Lee-Stone/esp32s3-lvgl-terminal/SquareLine_Project/assets/aa.jpg

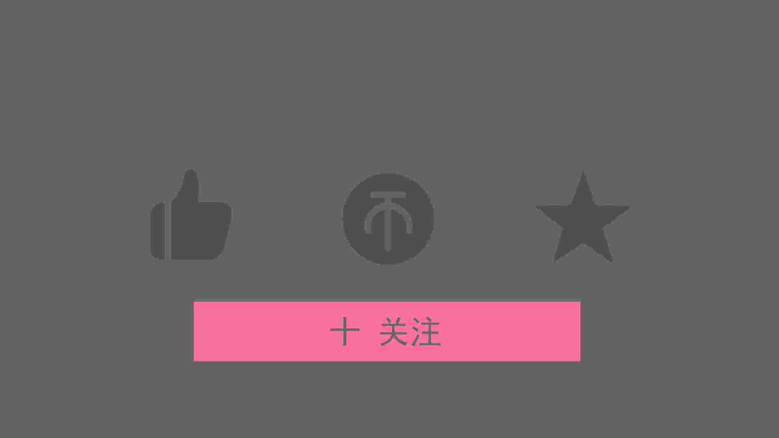
SquareLine_Project/assets/aa.jpg
