Lee-Stone/esp32s3-lvgl-terminal/SquareLine_Project/assets/ab.gif

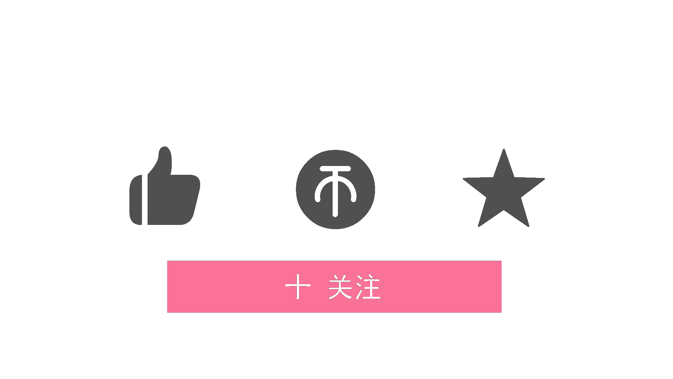
SquareLine_Project/assets/ab.gif
