Lee-Stone/esp32s3-lvgl-terminal/hardware/BOM_PCB_基于ESP32S3的智能终端V2.0.xlsx

No. | Quantity | Comment | Designator | Value
1 | 5 | Key_SMD_3x4x2 | BOOT,KEY1,KEY2,KEY3,RST
2 | 5 | 10uF | C1,C4,C5,C9,C11 | 10uF
3 | 10 | 100nF | C2,C3,C6,C7,C8,C10,C12,C13,C14,C17 | 100nF
4 | 1 | 100uF | C16 | 100uF
5 | 1 | 1uF | C18 | 1uF
6 | 1 | TF-02A | CARD1
7 | 1 | LED_0603-R | CHRG
8 | 1 | ZX-XH2.54-4PWT | CN1
9 | 1 | 1N5819WS | D1
10 | 2 | WAFER-PH2.0-2PWB | H1,H2
11 | 1 | MSM261D3526H1CPM | MIC
12 | 1 | LED_0603-B | PWR
13 | 1 | AO3401A | Q1
14 | 2 | AO3406 | Q2,Q3
15 | 1 | 0.4Ω | R1 | 0.4Ω
16 | 11 | 10K | R2,R3,R8,R9,R11,R13,R14,R15,R16,R17,R21 | 10K
17 | 1 | 1.5K | R4 | 1.5K
18 | 3 | 1K | R5,R6,R7 | 1K
19 | 6 | 5.1K | R10,R12,R18,R19,R20,R22 | 5.1K
20 | 1 | XL-3528RGBW-HM | RGB
21 | 1 | LED_0603-G | STDBY
22 | 1 | SS-1230W-G2 | SW1
23 | 1 | ESP32-S3-WROOM-1-N16R8 | U1
24 | 1 | TP4056X-42-ESOP8 | U2
25 | 1 | RT9013-33GB | U3
26 | 1 | 2.8寸电阻触摸屏 | U4
27 | 1 | XPT2046 | U5
28 | 1 | NS4168 | U6
29 | 1 | TYPE-C 16P QTGM027 | USB1
备注 | 2.8寸电阻触摸屏购买链接： 【淘宝】限时淘金币抵0.4元 https://e.tb.cn/h.RAMRivuBVRcLwcx?tk=EonXgpxdo21 CZ005 「2.4寸TFT显示屏电容触摸屏SPI串口屏4线焊接18pin驱动IC7789/9341」 点击链接直接打开 或者 淘宝搜索直接打开 其他元器件直接在淘宝上按照Comment名称搜索即可。
