Lee-Stone/esp32s3-lvgl-terminal/hardware/SCH_Schematic_基于ESP32S3的智能终端V2.0.pdf

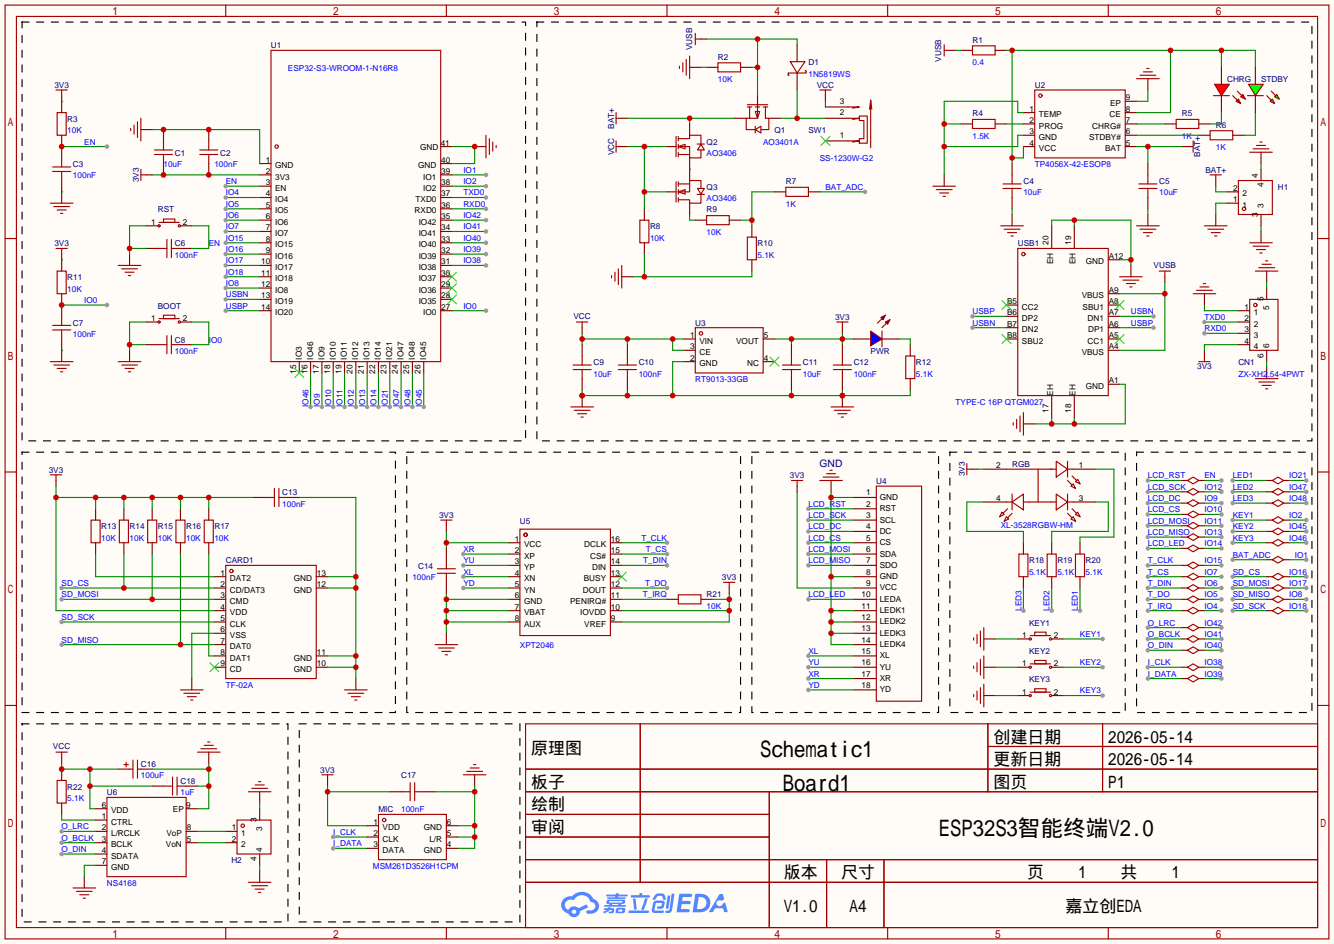
[picture p7: page 1]

IOVDD 10 PENIRQ# 11 DOUT 12 BUSY 13 DIN 14 CS# 15 DCLK 16

原理图 | Schematic1 | 创建日期 | 2026-05-14

更新日期 | 2026-05-14

板子 | Board1 | 图页 | P1
绘制 | | ESP32S3智能终端V2.0
审阅

V1.0 | A4 | 嘉立创EDA
