Lee-Stone/esp32s3-lvgl-terminal/hardware/SCH_Schematic_基于ESP32S3的智能终端.pdf

IO0 27 IO35 28 IO36 29 IO37 30 IO38 31 IO39 32 IO40 33 IO41 34 IO42 35 RXD0 36 TXD0 37 IO2 38 IO1 39 GND 40

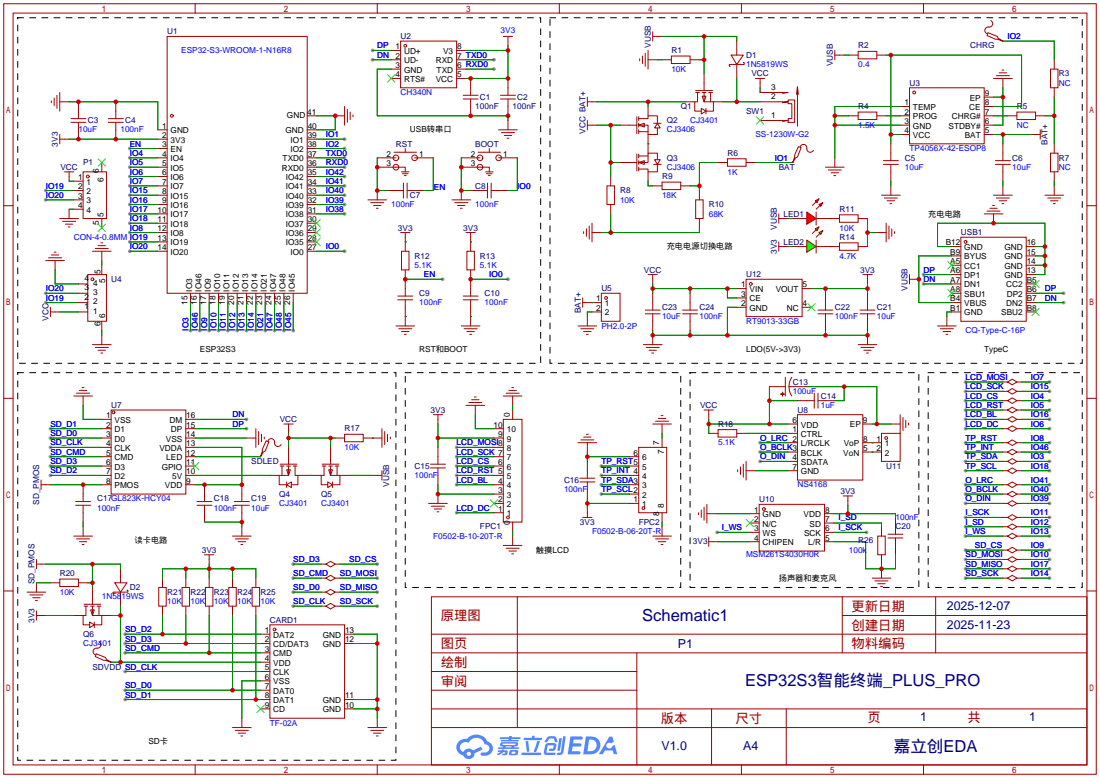
[picture p8: page 1]

5V 10 GPIO 11 LED 12 VDDA 13 VSS 14 DP 15 DM 16
