Lee-Stone/esp32s3-lvgl-terminal/src/lvgl_games/lv_100ask_2048/game2048.cpp

#include "game2048.h"
#include "lv_100ask_2048.h"
#include "../lv_games.h"

bool game_2048_flag = 0;

static void game_2048_event_cb(lv_event_t * e)
{
    lv_event_code_t code = lv_event_get_code(e);
    lv_obj_t * obj_2048 = lv_event_get_target(e);
    lv_obj_t * label = (lv_obj_t *)lv_event_get_user_data(e);
    
    if(code == LV_EVENT_VALUE_CHANGED) {
        if (lv_100ask_2048_get_best_tile(obj_2048) >= 2048)
            lv_label_set_text(label, "#00b329 YOU WIN! #");
        else if(lv_100ask_2048_get_status(obj_2048))
            lv_label_set_text(label, "#ff0000 GAME OVER! #");
        else
            lv_label_set_text_fmt(label, "SCORE: #ff00ff %d #", lv_100ask_2048_get_score(obj_2048));
    }
}

static void new_game_btn_event_handler(lv_event_t * e)
{
    lv_obj_t * obj_2048 = (lv_obj_t *)lv_event_get_user_data(e);

    lv_100ask_2048_set_new_game(obj_2048);
}


void lv_100ask_2048_simple_test(void)
{
    /*Create 2048 game*/
    lv_obj_t * obj_2048 = lv_100ask_2048_create(ui_GameSon);
#if LV_FONT_MONTSERRAT_40    
    lv_obj_set_style_text_font(obj_2048, &lv_font_montserrat_40, 0);
#endif
    lv_obj_set_size(obj_2048, 200, 200);
    lv_obj_center(obj_2048);
    lv_obj_align_to(obj_2048, ui_GameSon, LV_ALIGN_CENTER, 0, 10);

    /*Information*/
    lv_obj_t * label = lv_label_create(ui_GameSon);
    lv_label_set_recolor(label, true); 
    lv_label_set_text_fmt(label, "SCORE: #ff00ff %d #", lv_100ask_2048_get_score(obj_2048));
    lv_obj_align_to(label, obj_2048, LV_ALIGN_OUT_TOP_RIGHT, 0, -5);

    lv_obj_add_event_cb(obj_2048, game_2048_event_cb, LV_EVENT_ALL, label);

    /*New Game*/
    lv_obj_t * btn = lv_btn_create(ui_GameSon);
    lv_obj_align_to(btn, obj_2048, LV_ALIGN_OUT_TOP_LEFT, 0, -10);
    lv_obj_set_size(btn,80,20);
    lv_obj_add_event_cb(btn, new_game_btn_event_handler, LV_EVENT_CLICKED, obj_2048);

    label = lv_label_create(btn);
    lv_label_set_text(label, "New Game");
    lv_obj_center(label);

    ui_gameson_init();
}
