Lee-Stone/esp32s3-lvgl-terminal/(commit log)

2025-12-11 feat: update the entire project
    [BOM_PCB_基于ESP32S3的智能终端.xlsx, default_16MB.csv]
2026-11-03 feat: add board v2 images to readme
